swarup-p/bandgap-ref-on-sky130/layout/attempt3/bgr_a3.png

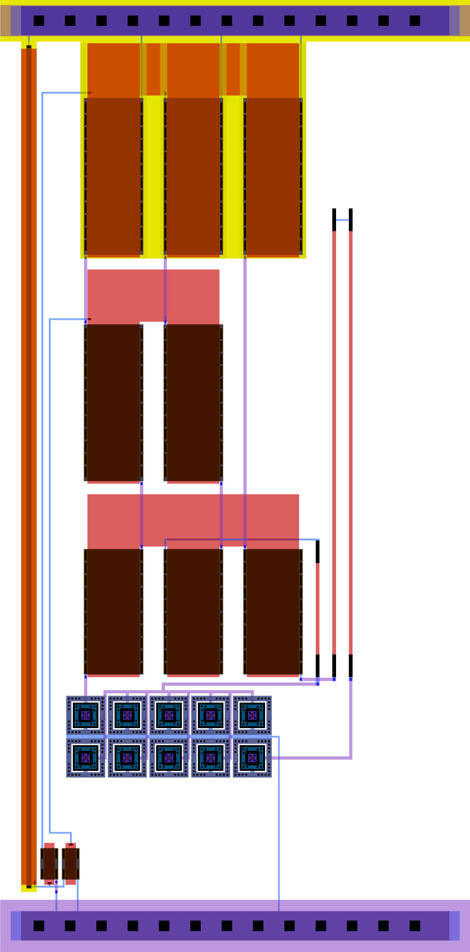
layout/attempt3/bgr_a3.png
