swarup-p/bandgap-ref-on-sky130/pre-layout/attempt_1/snapshots/bandgap_ref_cir.jpg

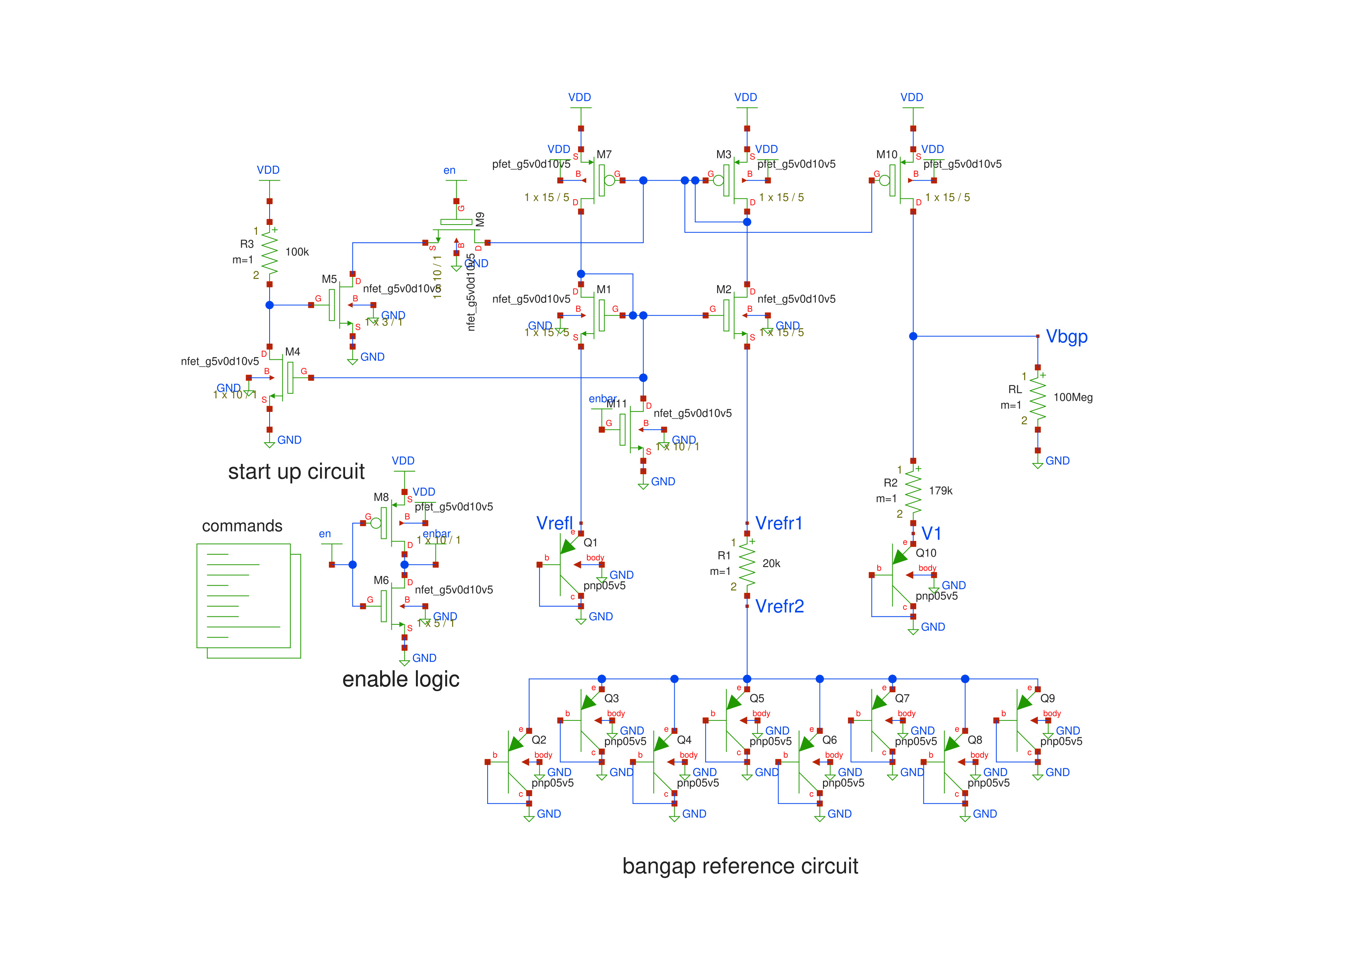
pre-layout/attempt_1/snapshots/bandgap_ref_cir.jpg
