swarup-p/bandgap-ref-on-sky130/pre-layout/attempt_1/snapshots/pre_sim_tv.jpg

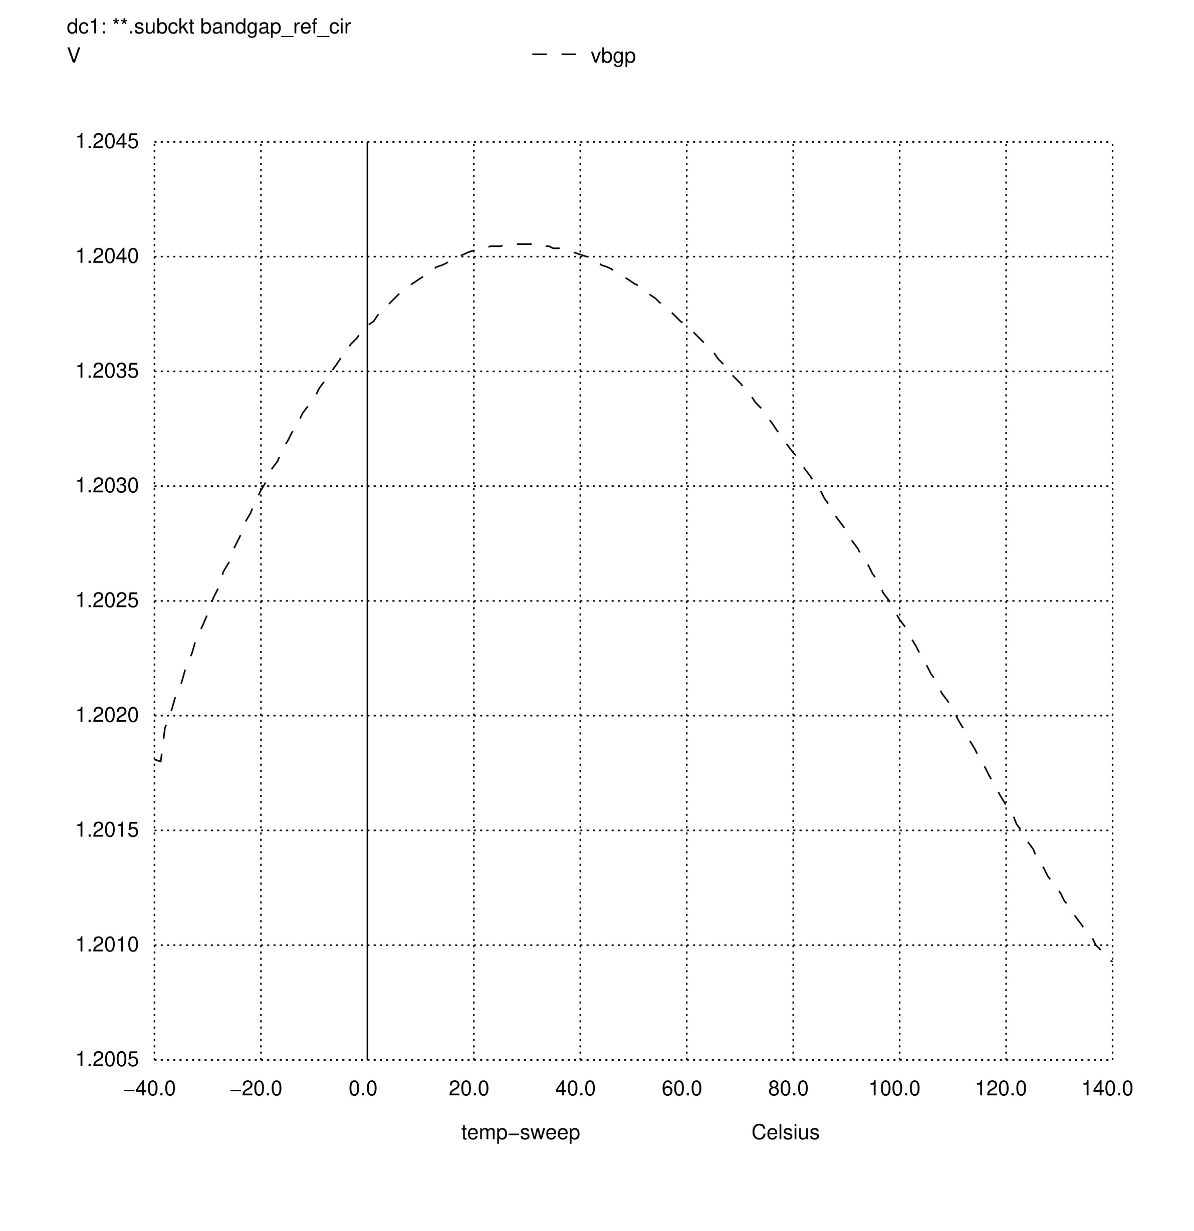
pre-layout/attempt_1/snapshots/pre_sim_tv.jpg
