swarup-p/bandgap-ref-on-sky130/pre-layout/attempt_2/snapshots/enable_function_check.jpg

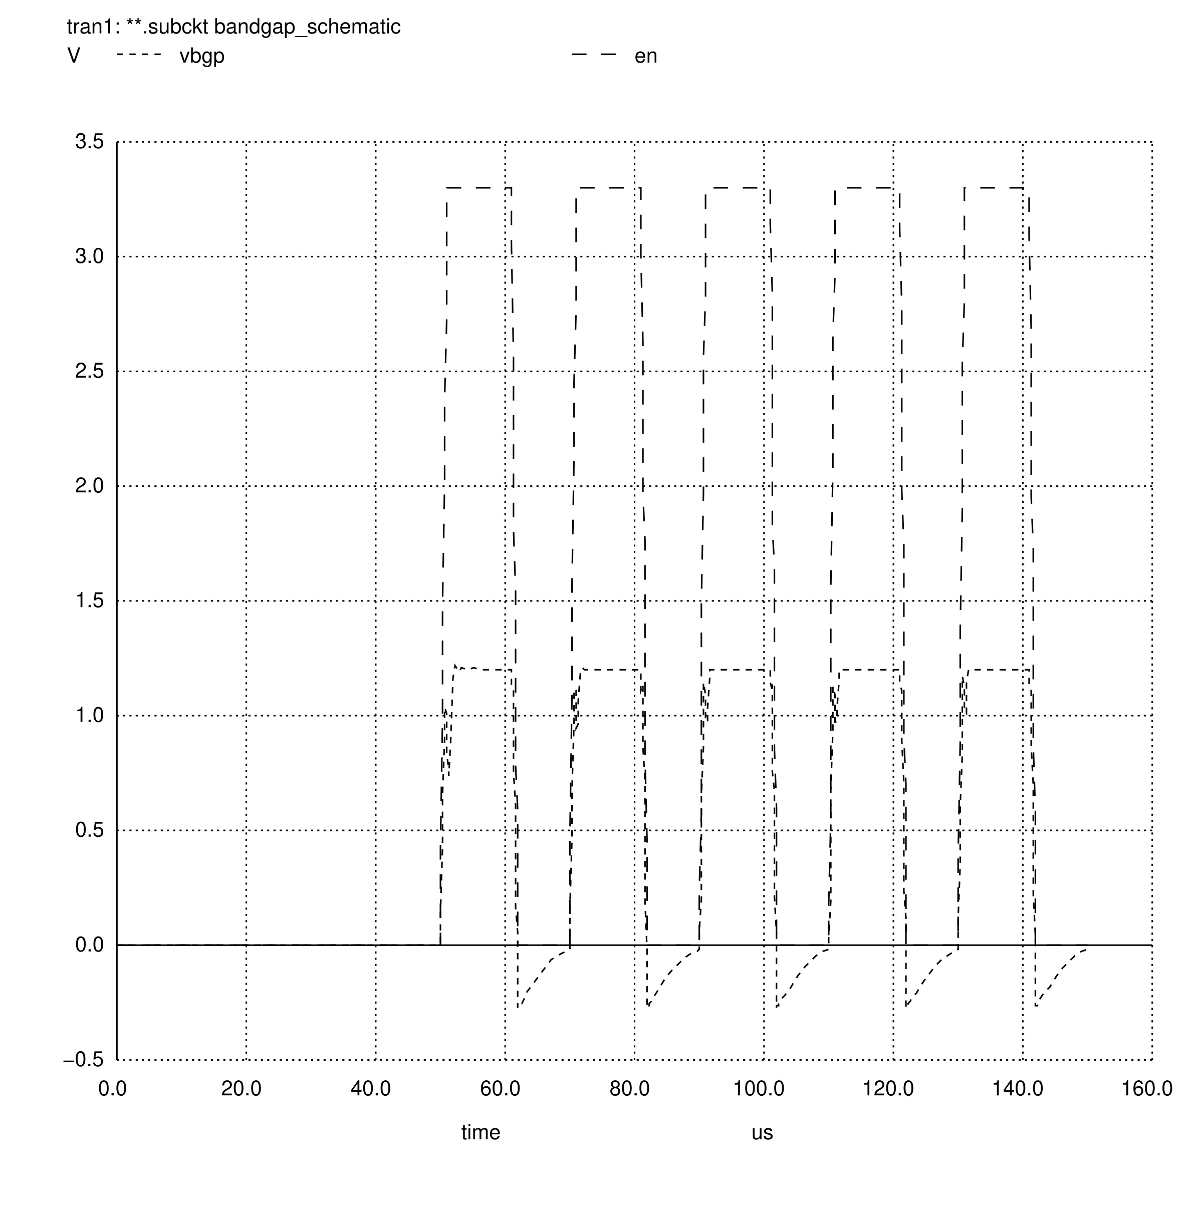
pre-layout/attempt_2/snapshots/enable_function_check.jpg
