swarup-p/bandgap-ref-on-sky130/pre-layout/attempt_2/snapshots/pre_startup_check.jpg

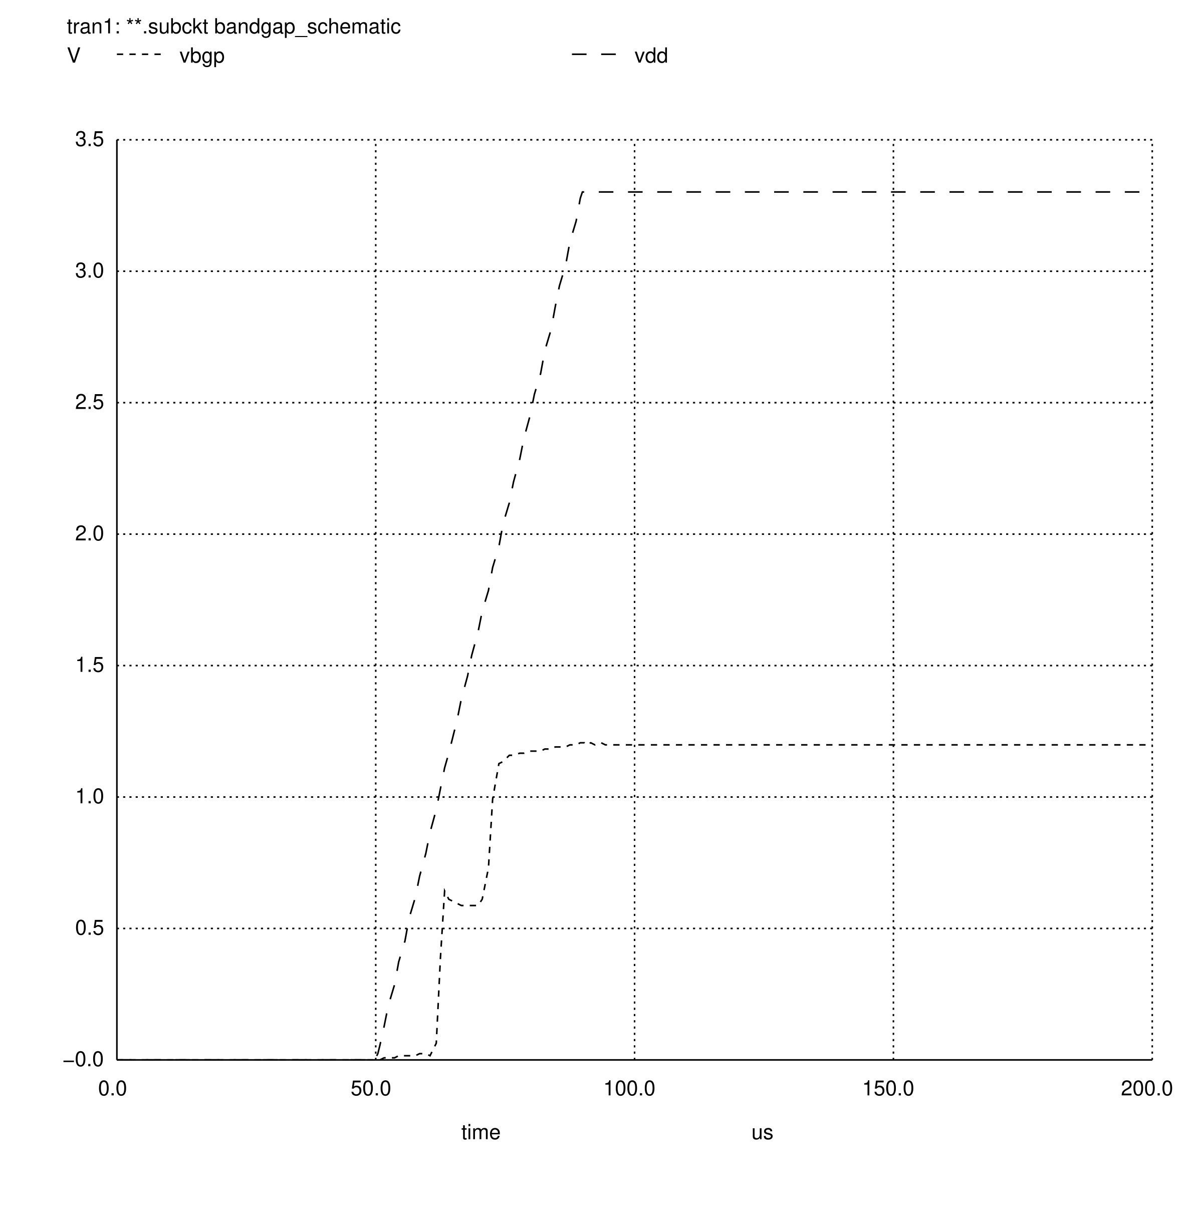
pre-layout/attempt_2/snapshots/pre_startup_check.jpg
