swarup-p/bandgap-ref-on-sky130/pre-layout/attempt_2/snapshots/pre_vc_check.jpg

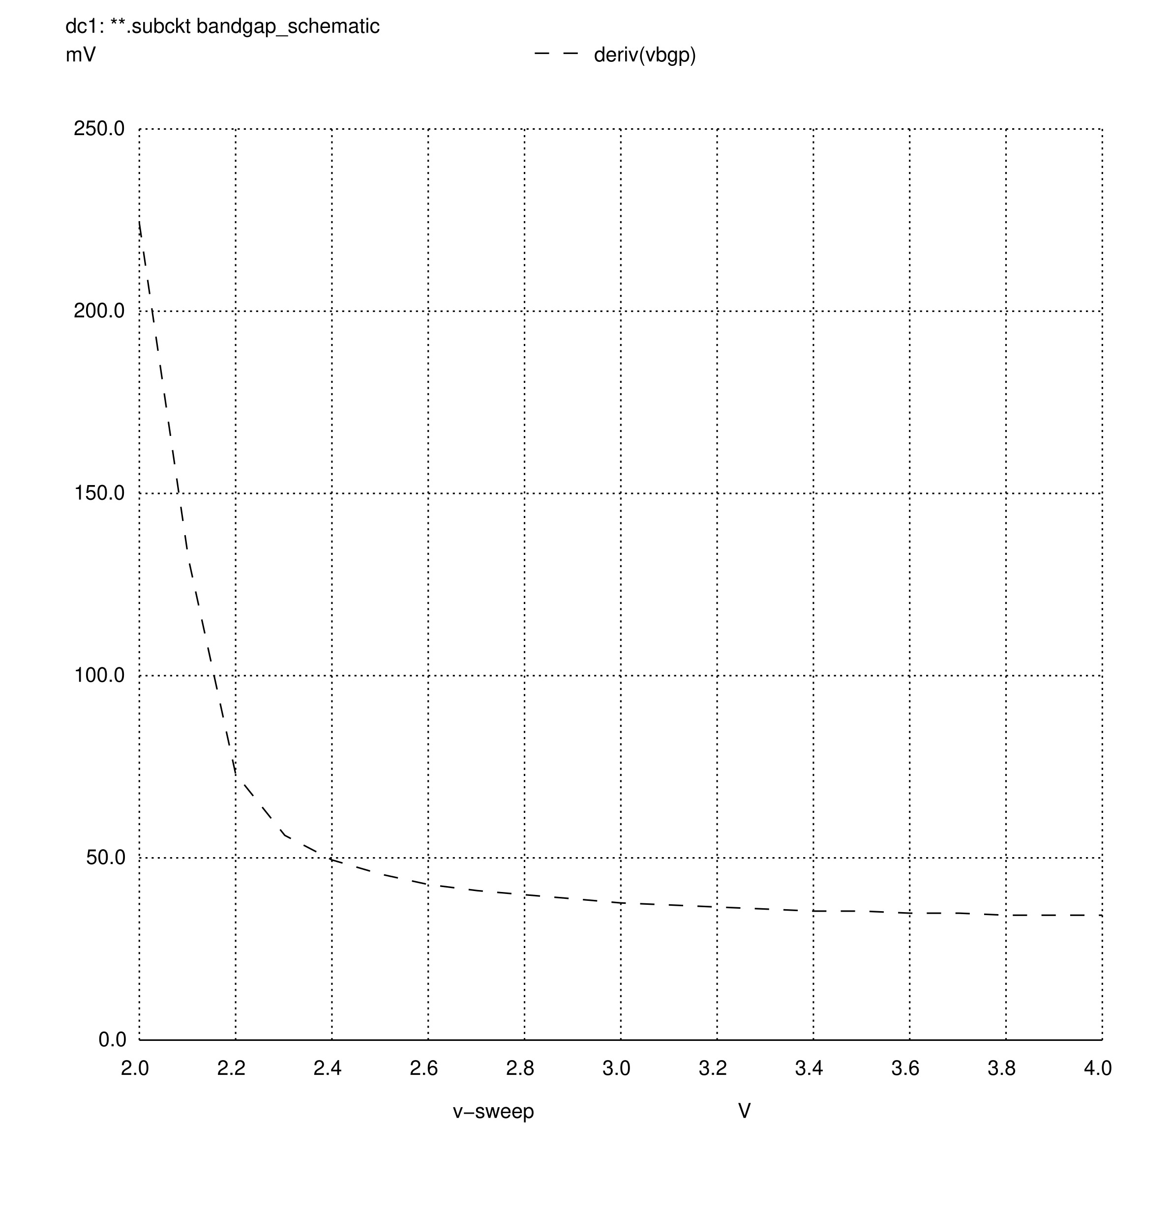
pre-layout/attempt_2/snapshots/pre_vc_check.jpg
