swarup-p/bandgap-ref-on-sky130/pre-layout/attempt_3/snapshots/bandgap_schematic.jpg

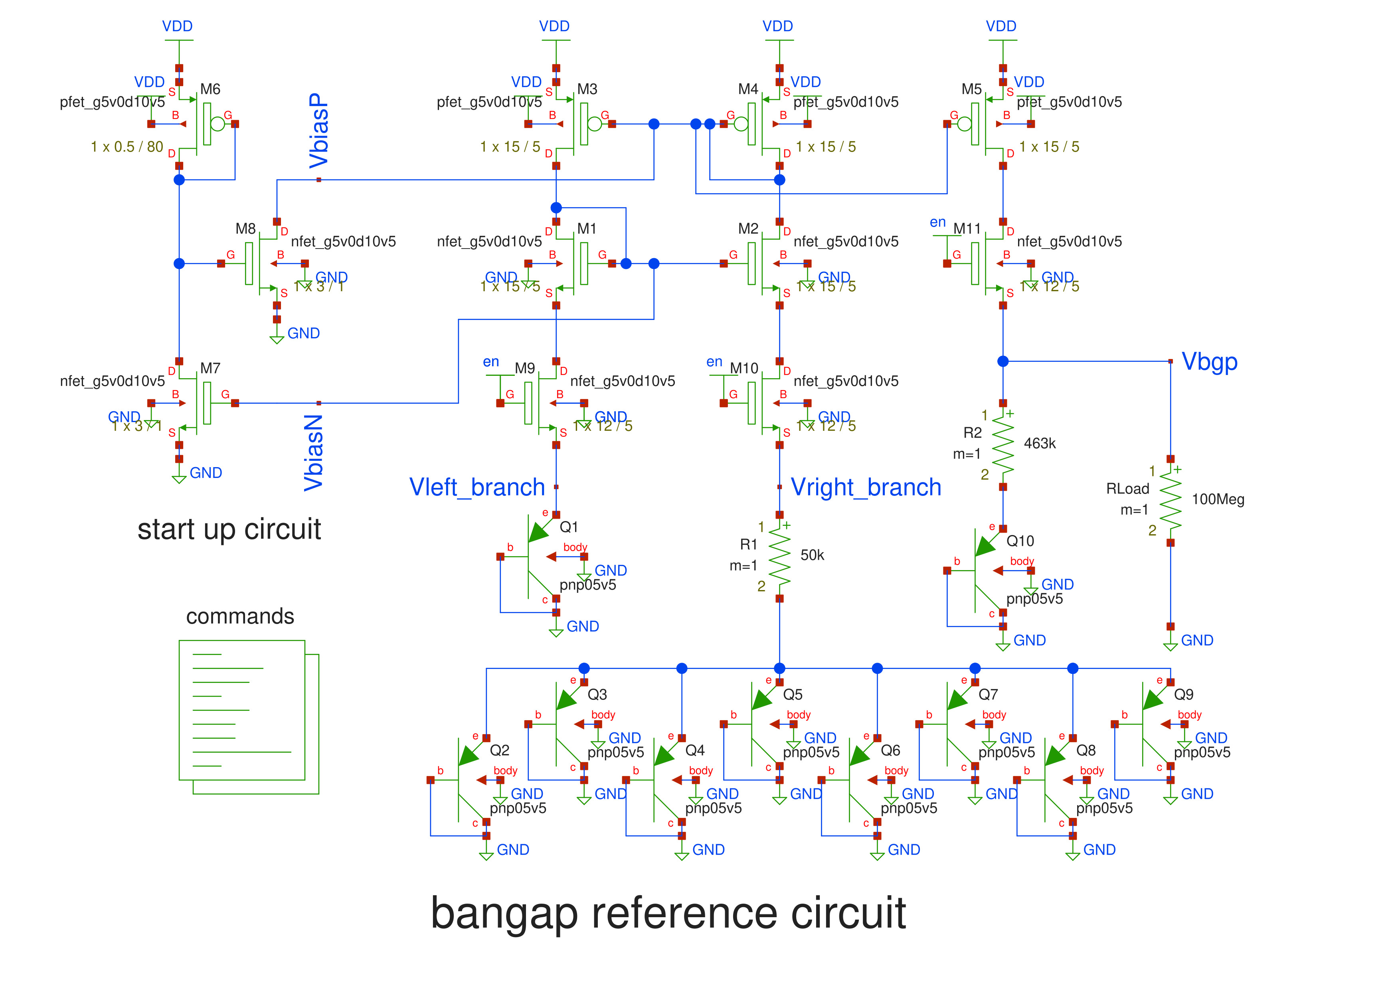
pre-layout/attempt_3/snapshots/bandgap_schematic.jpg
