swarup-p/bandgap-ref-on-sky130/pre-layout/attempt_3/snapshots/pre_startup_check.PNG

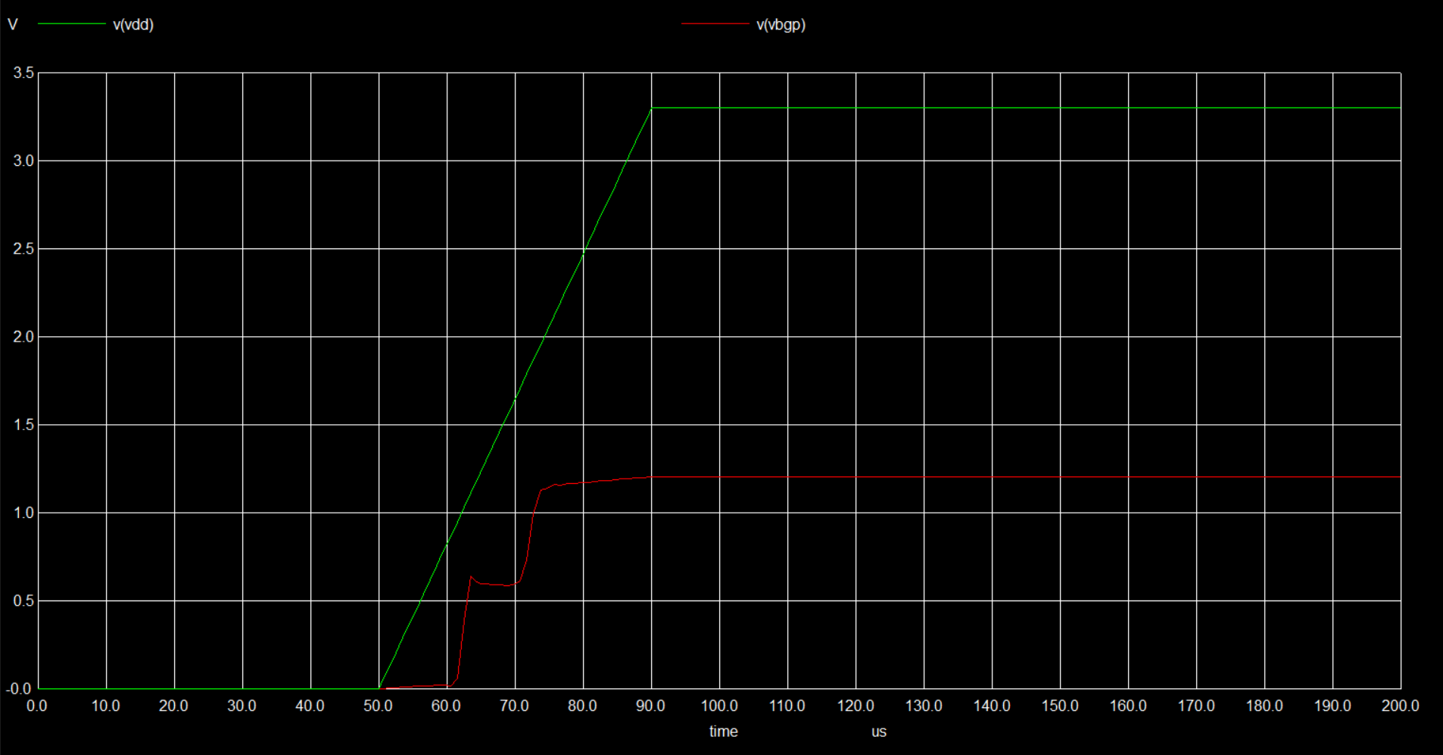
pre-layout/attempt_3/snapshots/pre_startup_check.PNG
