swarup-p/bandgap-ref-on-sky130/pre-layout/attempt_3/spice-deck/bandgap_schematic.spice

**.subckt bandgap_schematic
XM1 VbiasN VbiasN net4 GND sky130_fd_pr__nfet_g5v0d10v5 L=5 W=15 nf=1 ad='int((nf+1)/2) * W/nf * 0.29'
+ as='int((nf+2)/2) * W/nf * 0.29' pd='2*int((nf+1)/2) * (W/nf + 0.29)' ps='2*int((nf+2)/2) * (W/nf + 0.29)'
+ nrd='0.29 / W' nrs='0.29 / W' sa=0 sb=0 sd=0 mult=1 m=1 
XM2 VbiasP VbiasN net5 GND sky130_fd_pr__nfet_g5v0d10v5 L=5 W=15 nf=1 ad='int((nf+1)/2) * W/nf * 0.29'
+ as='int((nf+2)/2) * W/nf * 0.29' pd='2*int((nf+1)/2) * (W/nf + 0.29)' ps='2*int((nf+2)/2) * (W/nf + 0.29)'
+ nrd='0.29 / W' nrs='0.29 / W' sa=0 sb=0 sd=0 mult=1 m=1 
XM3 VbiasN VbiasP VDD VDD sky130_fd_pr__pfet_g5v0d10v5 L=5 W=15 nf=1 ad='int((nf+1)/2) * W/nf * 0.29'
+ as='int((nf+2)/2) * W/nf * 0.29' pd='2*int((nf+1)/2) * (W/nf + 0.29)' ps='2*int((nf+2)/2) * (W/nf + 0.29)'
+ nrd='0.29 / W' nrs='0.29 / W' sa=0 sb=0 sd=0 mult=1 m=1 
XQ1 GND GND Vleft_branch GND sky130_fd_pr__pnp_05v5_W3p40L3p40
XQ2 GND GND net1 GND sky130_fd_pr__pnp_05v5_W3p40L3p40
XM5 net3 VbiasP VDD VDD sky130_fd_pr__pfet_g5v0d10v5 L=5 W=15 nf=1 ad='int((nf+1)/2) * W/nf * 0.29' as='int((nf+2)/2) * W/nf * 0.29'
+ pd='2*int((nf+1)/2) * (W/nf + 0.29)' ps='2*int((nf+2)/2) * (W/nf + 0.29)' nrd='0.29 / W' nrs='0.29 / W'
+ sa=0 sb=0 sd=0 mult=1 m=1 
XQ3 GND GND net1 GND sky130_fd_pr__pnp_05v5_W3p40L3p40
XQ4 GND GND net1 GND sky130_fd_pr__pnp_05v5_W3p40L3p40
XQ5 GND GND net1 GND sky130_fd_pr__pnp_05v5_W3p40L3p40
XQ6 GND GND net1 GND sky130_fd_pr__pnp_05v5_W3p40L3p40
XQ7 GND GND net1 GND sky130_fd_pr__pnp_05v5_W3p40L3p40
XQ8 GND GND net1 GND sky130_fd_pr__pnp_05v5_W3p40L3p40
XQ9 GND GND net1 GND sky130_fd_pr__pnp_05v5_W3p40L3p40
R1 Vright_branch net1 50k m=1
R2 Vbgp net2 463k m=1
XQ10 GND GND net2 GND sky130_fd_pr__pnp_05v5_W3p40L3p40
XM4 VbiasP VbiasP VDD VDD sky130_fd_pr__pfet_g5v0d10v5 L=5 W=15 nf=1 ad='int((nf+1)/2) * W/nf * 0.29'
+ as='int((nf+2)/2) * W/nf * 0.29' pd='2*int((nf+1)/2) * (W/nf + 0.29)' ps='2*int((nf+2)/2) * (W/nf + 0.29)'
+ nrd='0.29 / W' nrs='0.29 / W' sa=0 sb=0 sd=0 mult=1 m=1 
XM7 net6 VbiasN GND GND sky130_fd_pr__nfet_g5v0d10v5 L=1 W=3 nf=1 ad='int((nf+1)/2) * W/nf * 0.29' as='int((nf+2)/2) * W/nf * 0.29'
+ pd='2*int((nf+1)/2) * (W/nf + 0.29)' ps='2*int((nf+2)/2) * (W/nf + 0.29)' nrd='0.29 / W' nrs='0.29 / W'
+ sa=0 sb=0 sd=0 mult=1 m=1 
XM8 VbiasP net6 GND GND sky130_fd_pr__nfet_g5v0d10v5 L=1 W=3 nf=1 ad='int((nf+1)/2) * W/nf * 0.29' as='int((nf+2)/2) * W/nf * 0.29'
+ pd='2*int((nf+1)/2) * (W/nf + 0.29)' ps='2*int((nf+2)/2) * (W/nf + 0.29)' nrd='0.29 / W' nrs='0.29 / W'
+ sa=0 sb=0 sd=0 mult=1 m=1 
RLoad Vbgp GND 100Meg m=1
XM9 net4 en Vleft_branch GND sky130_fd_pr__nfet_g5v0d10v5 L=5 W=12 nf=1 ad='int((nf+1)/2) * W/nf * 0.29'
+ as='int((nf+2)/2) * W/nf * 0.29' pd='2*int((nf+1)/2) * (W/nf + 0.29)' ps='2*int((nf+2)/2) * (W/nf + 0.29)'
+ nrd='0.29 / W' nrs='0.29 / W' sa=0 sb=0 sd=0 mult=1 m=1 
XM10 net5 en Vright_branch GND sky130_fd_pr__nfet_g5v0d10v5 L=5 W=12 nf=1 ad='int((nf+1)/2) * W/nf * 0.29'
+ as='int((nf+2)/2) * W/nf * 0.29' pd='2*int((nf+1)/2) * (W/nf + 0.29)' ps='2*int((nf+2)/2) * (W/nf + 0.29)'
+ nrd='0.29 / W' nrs='0.29 / W' sa=0 sb=0 sd=0 mult=1 m=1 
XM11 net3 en Vbgp GND sky130_fd_pr__nfet_g5v0d10v5 L=5 W=12 nf=1 ad='int((nf+1)/2) * W/nf * 0.29' as='int((nf+2)/2) * W/nf * 0.29'
+ pd='2*int((nf+1)/2) * (W/nf + 0.29)' ps='2*int((nf+2)/2) * (W/nf + 0.29)' nrd='0.29 / W' nrs='0.29 / W'
+ sa=0 sb=0 sd=0 mult=1 m=1 
XM6 net6 net6 VDD VDD sky130_fd_pr__pfet_g5v0d10v5 L=80 W=0.5 nf=1 ad='int((nf+1)/2) * W/nf * 0.29' as='int((nf+2)/2) * W/nf * 0.29'
+ pd='2*int((nf+1)/2) * (W/nf + 0.29)' ps='2*int((nf+2)/2) * (W/nf + 0.29)' nrd='0.29 / W' nrs='0.29 / W'
+ sa=0 sb=0 sd=0 mult=1 m=1 
**** begin user architecture code


.lib ../sky130_fd_pr/models/sky130_tt_bgr.lib.spice tt
.options savecurrents

*** plot vbgp with variation in supply voltage
*Vdd VDD GND 3.3
*V_en en GND 3.3
*.dc Vdd 2 4 0.1
*.control
*run
*print Vbgp
*plot V(Vbgp)
*.endc

*** plot vbgp with variation in temperature @3.3V
*Vdd VDD GND 3.3
*V_en en GND 3.3
*.dc temp -40 140 1
*.control
*run
*print V(Vbgp)
*plot V(Vbgp)
*.endc

*** plot voltage coefficient
*Vdd VDD GND 3.3
*V_en en GND 3.3
*.dc Vdd 2 4 0.1
*.control
*run
*plot deriv(V(Vbgp))
*.endc

*** plot temperature coefficient
*Vdd VDD GND 3.3
*V_en en GND 3.3
*.dc temp -40 140 1
*.control
*run
*plot deriv(V(Vbgp))/1.202344
*.endc

*** check start up circuit
V_en en GND 3.3
Vdd VDD GND PULSE(0 3.3 50us 40us 0us 200us 400us 0)
.tran 1us 200us
.control
run
plot V(Vdd) V(Vbgp)
.endc

*** enable pin
*Vdd VDD GND 3.3
*V_en en GND PULSE(0 3.3 50us 0 0 10us 20us 0)
*.tran 1u 150us
*.control
*run
*plot V(en) V(Vbgp)
*.endc


**** end user architecture code
**.ends
.GLOBAL GND
.GLOBAL VDD
.GLOBAL en
** flattened .save nodes
.end
