swarup-p/bandgap-ref-on-sky130/layout/attempt3/bgr_a3.spice

* SPICE3 file created from bgr_a3.ext - technology: sky130A

.option scale=5000u

X0 F GND sky130_fd_pr__pnp_05v5_W3p40L3p40_0/c_153_607# sky130_fd_pr__pnp_05v0 area=0
X1 C VbiasN VbiasP GND sky130_fd_pr__nfet_g5v0d10v5 w=3000 l=1000
X2 A GND sky130_fd_pr__pnp_05v5_W3p40L3p40_1/c_153_607# sky130_fd_pr__pnp_05v0 area=1.68755e+08
X3 G VbiasN VbiasN GND sky130_fd_pr__nfet_g5v0d10v5 w=3000 l=1000
X4 A GND sky130_fd_pr__pnp_05v5_W3p40L3p40_2/c_153_607# sky130_fd_pr__pnp_05v0 area=0
X5 A GND sky130_fd_pr__pnp_05v5_W3p40L3p40_3/c_153_607# sky130_fd_pr__pnp_05v0 area=0
X6 A GND sky130_fd_pr__pnp_05v5_W3p40L3p40_4/c_153_607# sky130_fd_pr__pnp_05v0 area=0
X7 A GND sky130_fd_pr__pnp_05v5_W3p40L3p40_5/c_153_607# sky130_fd_pr__pnp_05v0 area=0
X8 GND I VbiasP GND sky130_fd_pr__nfet_g5v0d10v5 w=600 l=200
X9 A GND sky130_fd_pr__pnp_05v5_W3p40L3p40_6/c_153_607# sky130_fd_pr__pnp_05v0 area=0
X10 GND VbiasN I GND sky130_fd_pr__nfet_g5v0d10v5 w=600 l=200
X11 A GND sky130_fd_pr__pnp_05v5_W3p40L3p40_7/c_153_607# sky130_fd_pr__pnp_05v0 area=0
X12 A GND sky130_fd_pr__pnp_05v5_W3p40L3p40_8/c_153_607# sky130_fd_pr__pnp_05v0 area=0
X13 J GND sky130_fd_pr__pnp_05v5_W3p40L3p40_9/c_153_607# sky130_fd_pr__pnp_05v0 area=0
X14 VDD VbiasP VbiasN VDD sky130_fd_pr__pfet_g5v0d10v5 w=3000 l=1000
X15 VDD VbiasP VbiasP VDD sky130_fd_pr__pfet_g5v0d10v5 w=3000 l=1000
X16 VDD VbiasP E VDD sky130_fd_pr__pfet_g5v0d10v5 w=3000 l=1000
X17 VDD I I VDD sky130_fd_pr__pfet_g5v0d10v5 w=100 l=16000
X18 G en F GND sky130_fd_pr__nfet_g5v0d10v5 w=2400 l=1000
X19 C en B GND sky130_fd_pr__nfet_g5v0d10v5 w=2400 l=1000
X20 Vbgp en E GND sky130_fd_pr__nfet_g5v0d10v5 w=2400 l=1000
X21 A B GND sky130_fd_pr__res_xhigh_po w=70 l=1750
X22 Vbgp H GND sky130_fd_pr__res_xhigh_po w=70 l=8102
X23 J H GND sky130_fd_pr__res_xhigh_po w=70 l=8102
C0 E B 0.06fF
C1 A J 0.02fF
C2 Vbgp A 0.89fF
C3 E en 0.58fF
C4 VbiasN en 0.23fF
C5 C E 0.15fF
C6 I VbiasP 0.07fF
C7 VbiasP VbiasN 3.79fF
C8 B en 1.45fF
C9 G en 0.58fF
C10 VDD VbiasP 1.23fF
C11 C B 0.06fF
C12 Vbgp B 0.04fF
C13 C en 0.58fF
C14 I VbiasN 0.03fF
C15 Vbgp J 0.14fF
C16 VDD I 0.00fF
C17 A F 0.09fF
C18 VDD E 0.00fF
C19 VDD VbiasN 0.00fF
C20 en GND 16.67fF
C21 VbiasN GND 4.28fF
C22 H GND 0.33fF
C23 Vbgp GND 0.82fF
C24 E GND 0.06fF
C25 B GND 0.89fF
C26 I GND 18.80fF
C27 VDD GND 66.88fF
C28 J GND 1.81fF
C29 A GND 3.04fF
C30 F GND 0.04fF
