swarup-p/bandgap-ref-on-sky130/(commit log)

2021-02-13 add basic schematic
2021-02-26 pre-layout schem and simulations
    [bandgap_schematic.sch]
2021-02-28 add description to run spice files
    [bandgap_schematic.sch]
2021-02-28 add pdk files as a library for spice
    [begin_of_life.bins.csv, end_of_life.bins.csv, ff.bins.csv, sky130_fd_pr__cap_vpp_02p4x04p6_m1m2_noshield.netlist.tsv, sky130_fd_pr__cap_vpp_02p7x06p1_m1m2m3m4_shieldl1_fingercap.netlist.tsv, sky130_fd_pr__cap_vpp_02p7x11p1_m1m2m3m4_shieldl1_fingercap.netlist.tsv, sky130_fd_pr__cap_vpp_02p7x21p1_m1m2m3m4_shieldl1_fingercap.netlist.tsv, sky130_fd_pr__cap_vpp_02p7x41p1_m1m2m3m4_shieldl1_fingercap.ne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]
2021-03-14 add layout tcl files
    [rules_ref_summary.ods]
2021-03-26 add final layout and restructure
    [avsdbgp_3V3.sch, bandgap_schematic.sch, begin_of_life.bins.csv, end_of_life.bins.csv, ff.bins.csv, sky130_fd_pr__cap_vpp_02p4x04p6_m1m2_noshield.netlist.tsv, sky130_fd_pr__cap_vpp_02p7x06p1_m1m2m3m4_shieldl1_fingercap.netlist.tsv, sky130_fd_pr__cap_vpp_02p7x11p1_m1m2m3m4_shieldl1_fingercap.netlist.tsv]
